precision-sustainable-ag/DIN_Flex_Converter/README.md

# DIN_Flex_Converter
A DIN rail mountable, Adjustable DC-DC converter for Common Low Voltage Conversions
