precision-sustainable-ag/DIN_Flex_Converter/DIN Enclosure/Flex Converter Cover Plate V1.DXF

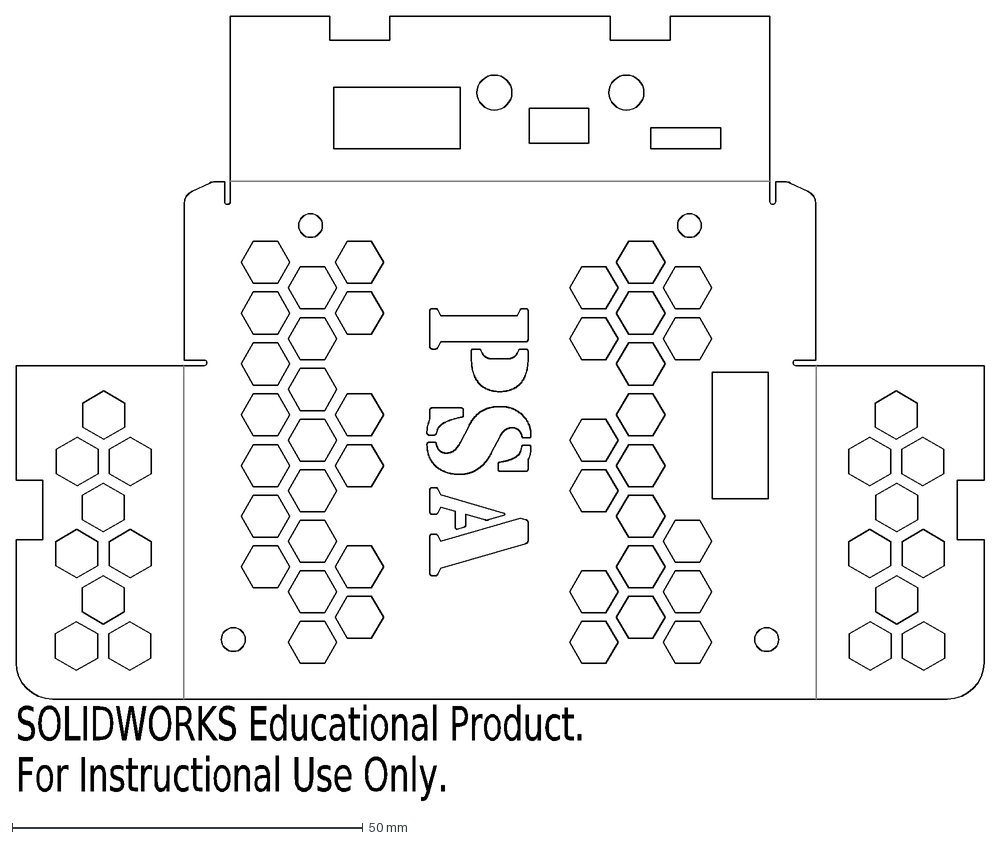
[picture p2: CAD file, 2024-05-08]
DIN Enclosure/Flex Converter Cover Plate V1.DXF
SOLIDWORKS Educational Product.
For Instructional Use Only.
