precision-sustainable-ag/DIN_Flex_Converter/(list of files, cad)

Other CAD files:
DIN Enclosure/PCBA/ZXTR2005Z-13.SLDASM
DIN Enclosure/DIN Flex Converter Assy.SLDASM
DIN Enclosure/PCBA/ASSEMBLY_12.SLDPRT
DIN Enclosure/RGC_Full-Feature.stp
DIN Enclosure/PCBA/ASSEMBLY_7.SLDPRT
DIN Enclosure/PCBA/ASSEMBLY_14.SLDPRT
DIN Enclosure/PCBA/ASSEMBLY_11.SLDPRT
DIN Enclosure/PCBA/pxc_2202344_01_PSPT-2-5-4-ST-KMGY_3D.SLDASM
DIN Enclosure/PCBA/ASSEMBLY_3.SLDPRT
DIN Enclosure/PCBA/ASSEMBLY_9.SLDPRT
DIN Enclosure/PCBA/3009P-1-154LF.SLDASM
DIN Enclosure/PCBA/ASSEMBLY_5.SLDPRT
DIN Enclosure/PCBA/ASSEMBLY_8.SLDPRT
DIN Enclosure/PCBA/ASSEMBLY_6.SLDPRT
DIN Enclosure/PCBA/I7C4W008A120V-0C3-R.SLDASM
DIN Enclosure/PCBA/R_1206_3216Metric.SLDASM
DIN Enclosure/PCBA/ASSEMBLY_2.SLDPRT
DIN Enclosure/PCBA/C_1206_3216Metric.SLDASM
DIN Enclosure/PCBA/74HCT04D_BJ_.SLDASM
DIN Enclosure/PCBA/ASSEMBLY_10.SLDPRT
DIN Enclosure/PCBA/WL-SMSW.SLDASM
DIN Enclosure/PCBA/DIN_Flex_Converter PCBA V1.SLDASM
DIN Enclosure/PCBA/CP_Elec_10x12.6.SLDASM
DIN Enclosure/PCBA/C_1210_3225Metric.SLDASM
DIN Enclosure/PCBA/EG1247.SLDASM
DIN Enclosure/PCBA/ASSEMBLY_4.SLDPRT
DIN Enclosure/PCBA/ASSEMBLY.SLDPRT
DIN Enclosure/PCBA/SSM-106-L-DV.SLDASM
DIN Enclosure/PCBA/ASSEMBLY_15.SLDPRT
DIN Enclosure/PCBA/ASSEMBLY_13.SLDPRT
DIN Enclosure/PCBA/DIN_Flex_Converter_pad_569.SLDPRT
DIN Enclosure/Base Bracket.SLDPRT
DIN Enclosure/PCBA/DIN_Flex_Converter_pad_704.SLDPRT
DIN Enclosure/Cover Plate.SLDPRT
DIN Enclosure/PCBA/DIN_Flex_Converter_pad_169.SLDPRT
DIN Enclosure/PCBA/DIN_Flex_Converter_pad_51.SLDPRT
DIN Enclosure/DIN_Flex_Converter.step
DIN Enclosure/PCBA/DIN_Flex_Converter_pad_429.SLDPRT
DIN Enclosure/PCBA/DIN_Flex_Converter_track_38.SLDPRT
DIN Enclosure/PCBA/DIN_Flex_Converter_pad_770.SLDPRT
DIN Enclosure/TW-06-05-L-D-320-120.SLDPRT
DIN Enclosure/PCBA/DIN_Flex_Converter_pad_194.SLDPRT
DIN Enclosure/PCBA/DIN_Flex_Converter_pad_198.SLDPRT
DIN Enclosure/PCBA/DIN_Flex_Converter_pad_332.SLDPRT
DIN Enclosure/I7C4W008A120V-0C3-R1.SLDPRT
DIN Enclosure/PCBA/i7C4W008A120V-0C3-R_27.SLDPRT
DIN Enclosure/PCBA/DIN_Flex_Converter_pad_423.SLDPRT
DIN Enclosure/dinm30.step
DIN Enclosure/PCBA/DIN_Flex_Converter_pad_49.SLDPRT
DIN Enclosure/PCBA/DIN_Flex_Converter_pad_714.SLDPRT
DIN Enclosure/PCBA/DIN_Flex_Converter_track_62.SLDPRT
DIN Enclosure/PCBA/DIN_Flex_Converter_pad_440.SLDPRT
DIN Enclosure/PCBA/DIN_Flex_Converter_track_16.SLDPRT
DIN Enclosure/PCBA/DIN_Flex_Converter_track_45.SLDPRT
DIN Enclosure/PCBA/DIN_Flex_Converter_pad_593.SLDPRT
DIN Enclosure/PCBA/DIN_Flex_Converter_pad_531.SLDPRT
DIN Enclosure/PCBA/i7C4W008A120V-0C3-R_32.SLDPRT
DIN Enclosure/PCBA/DIN_Flex_Converter_pad_414.SLDPRT
DIN Enclosure/PCBA/DIN_Flex_Converter_pad_672.SLDPRT
DIN Enclosure/PCBA/DIN_Flex_Converter_track_130.SLDPRT
DIN Enclosure/PCBA/i7C4W008A120V-0C3-R_50.SLDPRT
DIN Enclosure/PCBA/DIN_Flex_Converter_pad_785.SLDPRT
DIN Enclosure/PCBA/DIN_Flex_Converter_pad_681.SLDPRT
DIN Enclosure/PCBA/DIN_Flex_Converter_pad_699.SLDPRT
DIN Enclosure/PCBA/DIN_Flex_Converter_pad_628.SLDPRT
DIN Enclosure/PCBA/DIN_Flex_Converter_pad_542.SLDPRT
DIN Enclosure/PCBA/BCX5616TA_10.SLDPRT
DIN Enclosure/PCBA/DIN_Flex_Converter_track_54.SLDPRT
DIN Enclosure/PCBA/DIN_Flex_Converter_pad_524.SLDPRT
DIN Enclosure/PCBA/DIN_Flex_Converter_pad_150.SLDPRT
DIN Enclosure/PCBA/DIN_Flex_Converter_pad_412.SLDPRT
DIN Enclosure/PCBA/DIN_Flex_Converter_pad_760.SLDPRT
DIN Enclosure/PCBA/DIN_Flex_Converter_pad_277.SLDPRT
DIN Enclosure/PCBA/DIN_Flex_Converter_track_101.SLDPRT
DIN Enclosure/PCBA/DIN_Flex_Converter_pad_515.SLDPRT
DIN Enclosure/PCBA/DIN_Flex_Converter_pad_662.SLDPRT
DIN Enclosure/PCBA/DIN_Flex_Converter_pad_222.SLDPRT
DIN Enclosure/PCBA/DIN_Flex_Converter_pad_302.SLDPRT
DIN Enclosure/PCBA/DIN_Flex_Converter_pad_261.SLDPRT
DIN Enclosure/PCBA/DIN_Flex_Converter_pad_461.SLDPRT
DIN Enclosure/PCBA/DIN_Flex_Converter_pad_248.SLDPRT
DIN Enclosure/PCBA/DIN_Flex_Converter_track_13.SLDPRT
DIN Enclosure/PCBA/DIN_Flex_Converter_pad_447.SLDPRT
DIN Enclosure/PCBA/DIN_Flex_Converter_pad_19.SLDPRT
DIN Enclosure/PCBA/DIN_Flex_Converter_pad_396.SLDPRT
DIN Enclosure/PCBA/DIN_Flex_Converter_pad_673.SLDPRT
DIN Enclosure/PCBA/DIN_Flex_Converter_pad_548.SLDPRT
DIN Enclosure/PCBA/DIN_Flex_Converter_pad_783.SLDPRT
DIN Enclosure/PCBA/DIN_Flex_Converter_pad_774.SLDPRT
DIN Enclosure/PCBA/DIN_Flex_Converter_pad_333.SLDPRT
DIN Enclosure/PCBA/DIN_Flex_Converter_pad_227.SLDPRT
DIN Enclosure/PCBA/DIN_Flex_Converter_pad_75.SLDPRT
DIN Enclosure/PCBA/DIN_Flex_Converter_pad_609.SLDPRT
DIN Enclosure/PCBA/DIN_Flex_Converter_pad_308.SLDPRT
DIN Enclosure/PCBA/DIN_Flex_Converter_pad_787.SLDPRT
DIN Enclosure/PCBA/DIN_Flex_Converter_pad_94.SLDPRT
DIN Enclosure/PCBA/DIN_Flex_Converter_pad_318.SLDPRT
DIN Enclosure/PCBA/DIN_Flex_Converter_pad_186.SLDPRT
DIN Enclosure/PCBA/DIN_Flex_Converter_pad_27.SLDPRT
DIN Enclosure/PCBA/DIN_Flex_Converter_pad_717.SLDPRT
DIN Enclosure/PCBA/DIN_Flex_Converter_zone_6.SLDPRT
DIN Enclosure/PCBA/DIN_Flex_Converter_pad_303.SLDPRT
DIN Enclosure/PCBA/DIN_Flex_Converter_pad_62.SLDPRT
DIN Enclosure/PCBA/DIN_Flex_Converter_track_67.SLDPRT
DIN Enclosure/PCBA/DIN_Flex_Converter_pad_263.SLDPRT
DIN Enclosure/PCBA/DIN_Flex_Converter_pad_172.SLDPRT
DIN Enclosure/PCBA/DIN_Flex_Converter_pad_399.SLDPRT
DIN Enclosure/PCBA/DIN_Flex_Converter_pad_367.SLDPRT
DIN Enclosure/PCBA/DIN_Flex_Converter_track_105.SLDPRT
DIN Enclosure/PCBA/DIN_Flex_Converter_track_82.SLDPRT
DIN Enclosure/PCBA/DIN_Flex_Converter_pad_530.SLDPRT
DIN Enclosure/PCBA/DIN_Flex_Converter_pad_193.SLDPRT
DIN Enclosure/PCBA/DIN_Flex_Converter_pad_736.SLDPRT
DIN Enclosure/PCBA/DIN_Flex_Converter_pad_642.SLDPRT
DIN Enclosure/PCBA/DIN_Flex_Converter_pad_763.SLDPRT
DIN Enclosure/PCBA/DIN_Flex_Converter_pad_24.SLDPRT
DIN Enclosure/PCBA/DIN_Flex_Converter_track_2.SLDPRT
DIN Enclosure/PCBA/DIN_Flex_Converter_track_32.SLDPRT
DIN Enclosure/PCBA/i7C4W008A120V-0C3-R_40.SLDPRT
DIN Enclosure/PCBA/DIN_Flex_Converter_zone_5.SLDPRT
DIN Enclosure/PCBA/DIN_Flex_Converter_pad_733.SLDPRT
DIN Enclosure/PCBA/DIN_Flex_Converter_pad_22.SLDPRT
DIN Enclosure/PCBA/DIN_Flex_Converter_pad_16.SLDPRT
DIN Enclosure/PCBA/DIN_Flex_Converter_pad_163.SLDPRT
DIN Enclosure/PCBA/DIN_Flex_Converter_pad_527.SLDPRT
DIN Enclosure/PCBA/DIN_Flex_Converter_pad_55.SLDPRT
DIN Enclosure/PCBA/DIN_Flex_Converter_pad_210.SLDPRT
DIN Enclosure/PCBA/DIN_Flex_Converter_pad_203.SLDPRT
DIN Enclosure/PCBA/DIN_Flex_Converter_pad_260.SLDPRT
DIN Enclosure/PCBA/DIN_Flex_Converter_track_70.SLDPRT
DIN Enclosure/PCBA/DIN_Flex_Converter_pad_463.SLDPRT
DIN Enclosure/PCBA/DIN_Flex_Converter_pad_71.SLDPRT
DIN Enclosure/PCBA/DIN_Flex_Converter_pad_247.SLDPRT
DIN Enclosure/PCBA/DIN_Flex_Converter_zone_12.SLDPRT
DIN Enclosure/PCBA/DIN_Flex_Converter_pad_577.SLDPRT
DIN Enclosure/PCBA/DIN_Flex_Converter_pad_711.SLDPRT
DIN Enclosure/PCBA/DIN_Flex_Converter_pad_90.SLDPRT
DIN Enclosure/PCBA/DIN_Flex_Converter_track_152.SLDPRT
DIN Enclosure/PCBA/DIN_Flex_Converter_pad_37.SLDPRT
DIN Enclosure/PCBA/BCX5616TA_8.SLDPRT
DIN Enclosure/PCBA/DIN_Flex_Converter_pad_549.SLDPRT
DIN Enclosure/PCBA/i7C4W008A120V-0C3-R_21.SLDPRT
DIN Enclosure/PCBA/DIN_Flex_Converter_pad_157.SLDPRT
DIN Enclosure/PCBA/DIN_Flex_Converter_pad_48.SLDPRT
DIN Enclosure/PCBA/DIN_Flex_Converter_pad_514.SLDPRT
DIN Enclosure/PCBA/DIN_Flex_Converter_pad_707.SLDPRT
DIN Enclosure/PCBA/DIN_Flex_Converter_pad_310.SLDPRT
DIN Enclosure/PCBA/DIN_Flex_Converter_pad_205.SLDPRT
DIN Enclosure/103542-5.SLDPRT
DIN Enclosure/103542-5.stp
DIN Enclosure/91263A823_Zinc-Plated Alloy Steel Hex Drive Flat Head Screw.SLDPRT
DIN Enclosure/91263A824_Zinc-Plated Alloy Steel Hex Drive Flat Head Screw.SLDPRT
DIN Enclosure/91306A655_Button Head Hex Drive Screws.SLDPRT
DIN Enclosure/91306A660_Button Head Hex Drive Screws.SLDPRT
DIN Enclosure/Base Bracket.DXF
DIN Enclosure/Cover Plate.DXF
DIN Enclosure/DIN_Flex_Converter.SLDPRT
DIN Enclosure/PCBA/0678L9100-02.SLDPRT
DIN Enclosure/PCBA/0678L9100-02_2.SLDPRT
DIN Enclosure/PCBA/0678L9100-02_3.SLDPRT
DIN Enclosure/PCBA/0678L9250-02.SLDASM
DIN Enclosure/PCBA/155124RS73200.SLDPRT
DIN Enclosure/PCBA/155124RS73200_2.SLDPRT
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
