precision-sustainable-ag/DIN_Flex_Converter/PCB/DIN_Flex_Converter.kicad_pcb

## KiCad design PCB/DIN_Flex_Converter.kicad_pcb (2024-06-21)

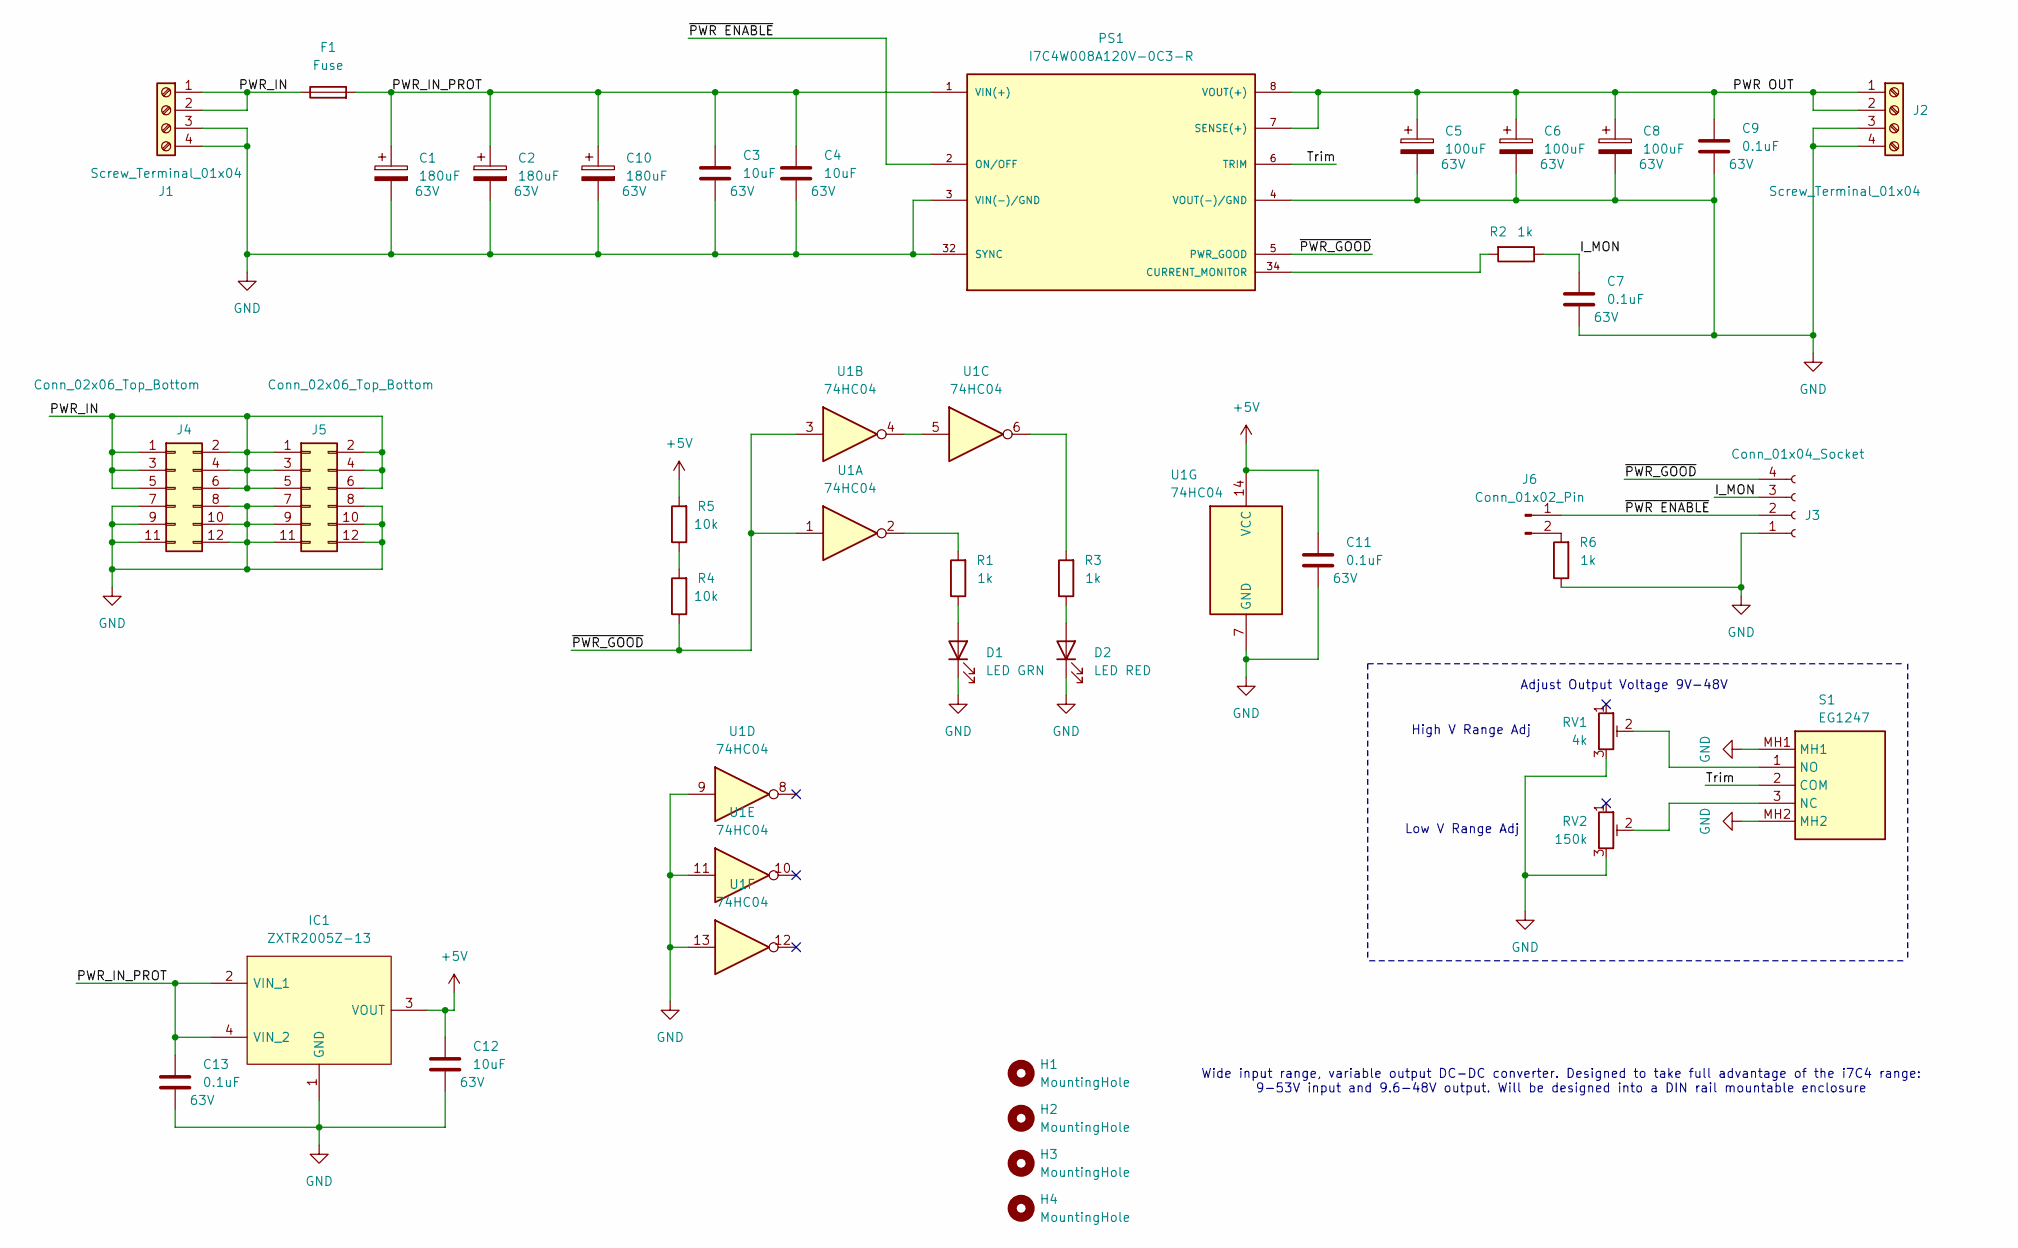
[picture p3: schematic DIN_Flex_Converter.kicad_sch]

Parts:
C1, C2, C10: 180uF; CP_Elec_10x12.6; Voltage 63V
C3, C4, C12: 10uF; C_1210_3225Metric; Voltage 63V
C5, C6, C8: 100uF; CP_Elec_10x12.6; Voltage 63V
C7, C9, C11, C13: 0.1uF; C_1206_3216Metric; Voltage 63V
D1: LED GRN; LED_155124RV73200
D2: LED RED; LED_155124RV73200
F1: Fuse; FUSC9830X318N
H1, H2, H3, H4: MountingHole; MountingHole_3.2mm_M3_DIN965
IC1: ZXTR2005Z-13; AZ7042RTRG1; Mouser Part Number 621-ZXTR2005Z-13
J1: Screw_Terminal_01x04; PHOENIX_2907774
J2: Screw_Terminal_01x04; PHOENIX_2907787
J3: Conn_01x04_Socket; PHOENIX_1803293
J4, J5: Conn_02x06_Top_Bottom; SSM-106-XXX-DV
J6: Conn_01x02_Pin; PinHeader_1x02_P2.54mm_Vertical
PS1: I7C4W008A120V-0C3-R; CONV_I7C4W008A120V-0C3-R
R1, R2, R3, R6: 1k; R_1206_3216Metric
R4, R5: 10k; R_1206_3216Metric
RV1: 4k; 3009P1154LF
RV2: 150k; 3009P1154LF
S1: EG1247; Mouser Part Number 612-EG1247
U1: 74HC04; SOIC127P600X175-14N

Connections:
+5V: C11.1, C12.1, IC1.3 (VOUT), R5.2, U1.14 (VCC)
/I_MON: C7.1, J3.3, R2.1
/PWR OUT: C5.1, C6.1, C8.1, C9.1, J2.1, J2.2, PS1.7 (SENSE(+)), PS1.8 (VOUT(+))
/PWR_IN: F1.1, J1.1, J1.2, J4.1, J4.2, J4.3, J4.4, J4.5, J4.6, J5.1, J5.2, J5.3, J5.4, J5.5, J5.6
/PWR_IN_PROT: C1.1, C2.1, C3.1, C4.1, C10.1, C13.1, F1.2, IC1.2 (VIN_1), IC1.4 (VIN_2), PS1.1 (VIN(+))
/Trim: PS1.6 (TRIM), S1.2 (COM)
/~PWR ENABLE: J3.2, J6.1, PS1.2 (ON/OFF); also elsewhere on the board
/~PWR_GOOD: J3.4, PS1.5 (PWR_GOOD), R4.1, U1.1, U1.3
GND: C1.2, C2.2, C3.2, C4.2, C5.2, C6.2, C7.2, C8.2, C9.2, C10.2, C11.2, C12.2, C13.2, D1.1 (K), D2.1 (K), IC1.1 (GND), J1.3, J1.4, J2.3, J2.4, J3.1, J4.7, J4.8, J4.9, J4.10, J4.11, J4.12, J5.7, J5.8, J5.9, J5.10, J5.11, J5.12, PS1.3 (VIN(-)/GND), PS1.4 (VOUT(-)/GND), PS1.32 (SYNC), R6.1, RV1.3, RV2.3, S1.MH1, S1.MH2, U1.7 (GND), U1.9, U1.11, U1.13
unnamed: D1.2 (A), R1.1
unnamed: D2.2 (A), R3.1
unnamed 11: J6.2, R6.2; also elsewhere on the board
unnamed: PS1.34 (CURRENT_MONITOR), R2.2
unnamed: R1.2, U1.2
unnamed: R3.2, U1.6
unnamed: R4.2, R5.1
unnamed: RV2.2, S1.3 (NC)
unnamed: RV1.2, S1.1 (NO)
unnamed: U1.4, U1.5

Notes on the sheet:
Adjust Output Voltage 9V-48V
High V Range Adj
Low V Range Adj
Wide input range, variable output DC-DC converter. Designed to take full advantage of the i7C4 range: 9-53V input and 9.6-48V output. Will be designed into a DIN rail mountable enclosure

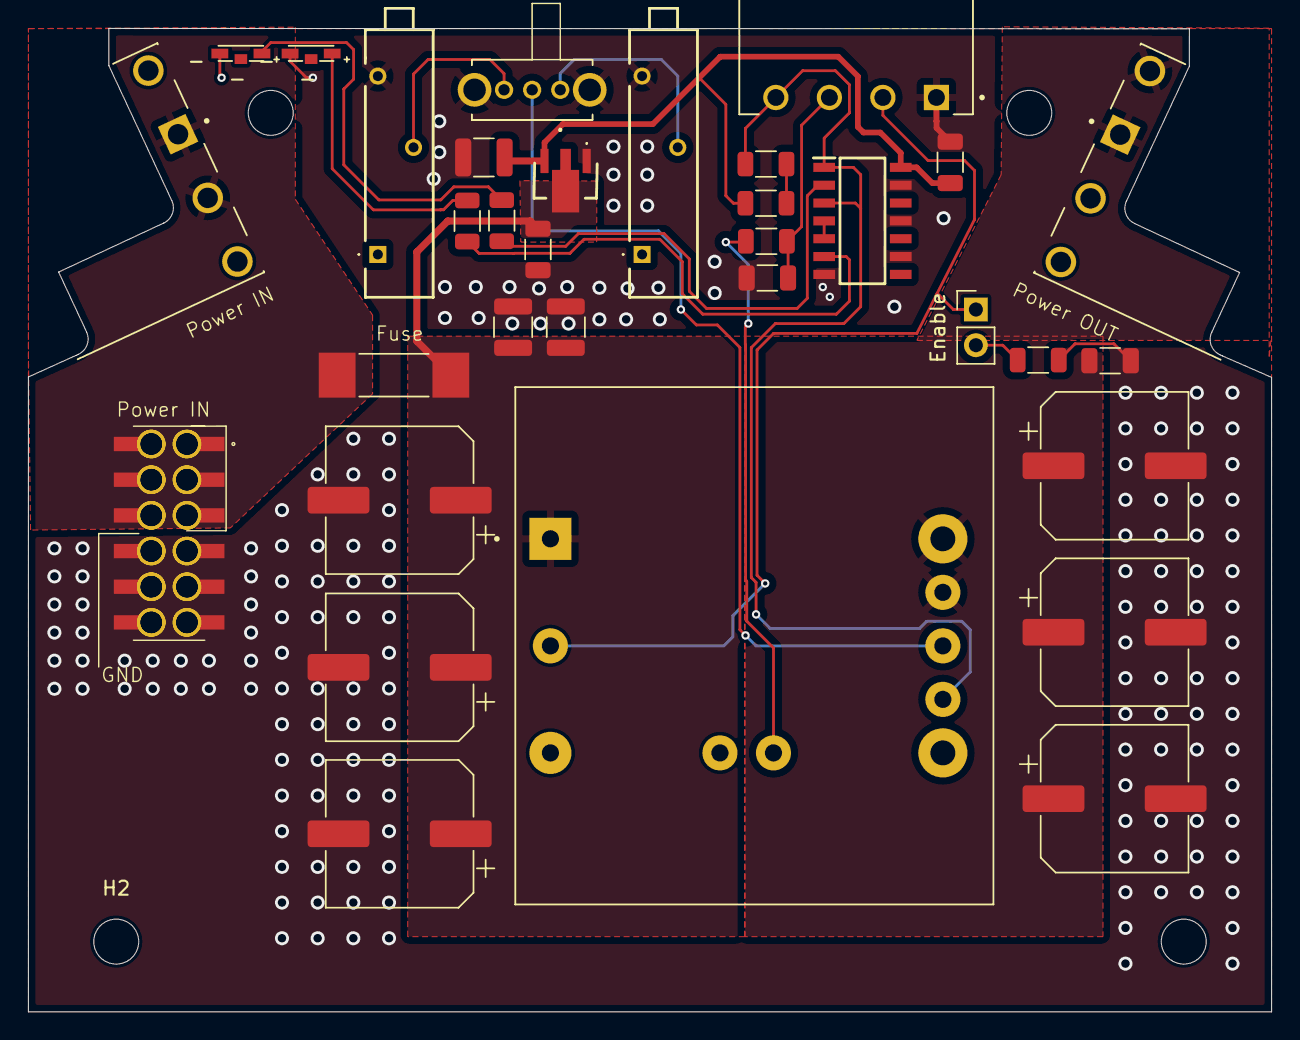
[picture p4: board DIN_Flex_Converter.kicad_pcb from above]

Board: 2 copper layers, 88.5 x 70.0 mm, 38 parts (1 on the bottom side), 19 nets.

Other parts of the board:
Enable: Conn_01x02_Pin; PinHeader_1x02_P2.54mm_Vertical

Their connections:
/~PWR ENABLE: Enable.1; also elsewhere on the board
unnamed 11: Enable.2; also elsewhere on the board
