precision-sustainable-ag/DIN_Flex_Converter/(commit log)

2024-05-06 Inital DC to DC module schematic
    [DIN_Flex_Converter.kicad_pcb, DIN_Flex_Converter.kicad_sch]
2024-05-06 Added Trim & Linear Regulator
    [DIN_Flex_Converter.csv, DIN_Flex_Converter.kicad_pcb, DIN_Flex_Converter.kicad_sch]
2024-05-06 Added Indication Ckt to Schematic
    [DIN_Flex_Converter.kicad_pcb, DIN_Flex_Converter.kicad_sch]
2024-05-07 Draft Schematic & Layout
    [DIN Flex Converter Assy.SLDASM, DIN_Flex_Converter.SLDPRT, DIN_Flex_Converter.kicad_pcb, DIN_Flex_Converter.kicad_sch, DIN_Flex_Converter.step, dinm30.SLDPRT, dinm30.step]
2024-05-08 Enclosure Draft
    [91263A823_Zinc-Plated Alloy Steel Hex Drive Flat Head Screw.SLDPRT, 91263A824_Zinc-Plated Alloy Steel Hex Drive Flat Head Screw.SLDPRT, 91306A655_Button Head Hex Drive Screws.SLDPRT, 91306A660_Button Head Hex Drive Screws.SLDPRT, Base Bracket.DXF, Base Bracket.SLDPRT, Cover Plate.DXF, Cover Plate.SLDPRT]
2024-05-08 Layout & Route Draft Complete
    [103542-5.SLDPRT, 103542-5.stp, Cover Plate.SLDPRT, DIN Flex Converter Assy.SLDASM, DIN_Flex_Converter.kicad_pcb, DIN_Flex_Converter.kicad_sch, TW-06-05-L-D-320-120.SLDPRT]
2024-05-08 PCB Finalized and manufacturing files generated
    [DIN_Flex_Converter.kicad_pcb, DIN_Flex_Converter.kicad_sch, DIN_Flex_Converter.step, bom.csv, designators.csv, positions.csv]
2024-05-08 Exported 3D PCBA from KiCad & Imported into SW
    [0678L9100-02.SLDPRT, 0678L9100-02_2.SLDPRT, 0678L9100-02_3.SLDPRT, 0678L9250-02.SLDASM, 155124RS73200.SLDPRT, 155124RS73200_2.SLDPRT, 155124RS73200_3.SLDPRT, 155124RS73200_4.SLDPRT]
2024-05-08 V1 Design Complete, all parts ordered.
    [Base Bracket.SLDPRT, Cover Plate.SLDPRT, DIN Flex Converter Assy.SLDASM, Flex Converter Base Plate V1.DXF, Flex Converter Cover Plate V1.DXF]
2024-06-21 fixed LED footprint/routing and added enable jumper
    [DIN_Flex_Converter.kicad_pcb, DIN_Flex_Converter.kicad_sch]
2025-08-22 Add PnP File For SMD Assembly on LumenPnP
